mhvwerts/SFRMATRIX-LED-light/LED_holder_SM30tube/bague_portediode.pdf

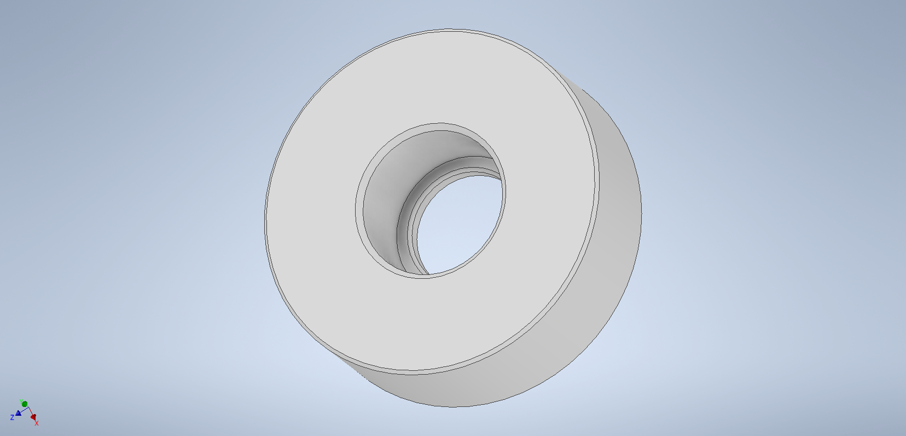
[picture p6: page 1]
