mhvwerts/SFRMATRIX-LED-light/LED_holder_SM30tube/sup_diode4mm.pdf

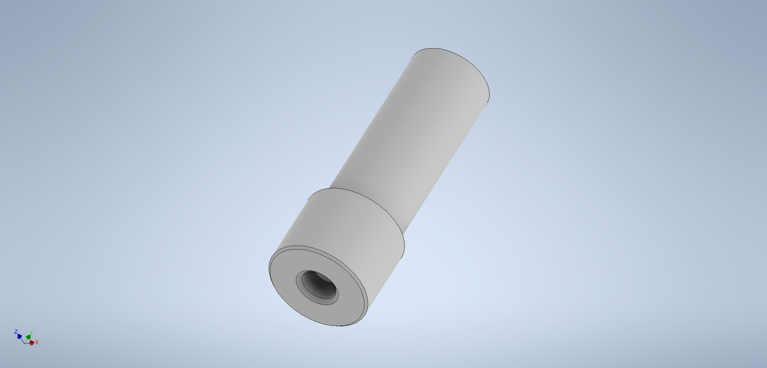
[picture p7: page 1]
