mhvwerts/SFRMATRIX-LED-light/LED_holder_SM30tube/sup_diode3mm.stl

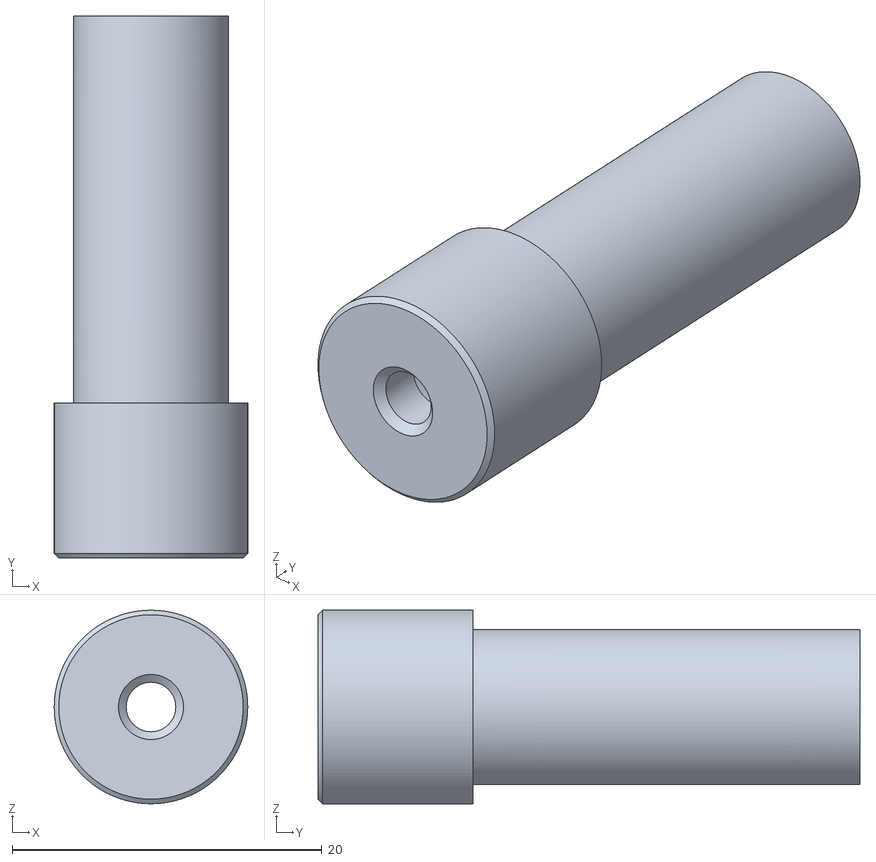
[picture p8: CAD file, 2026-10-27]
LED_holder_SM30tube/sup_diode3mm.stl
12.5 x 35.0 x 12.5
