mhvwerts/SFRMATRIX-LED-light/LED_holder_SM30tube/bague_portediode.stl

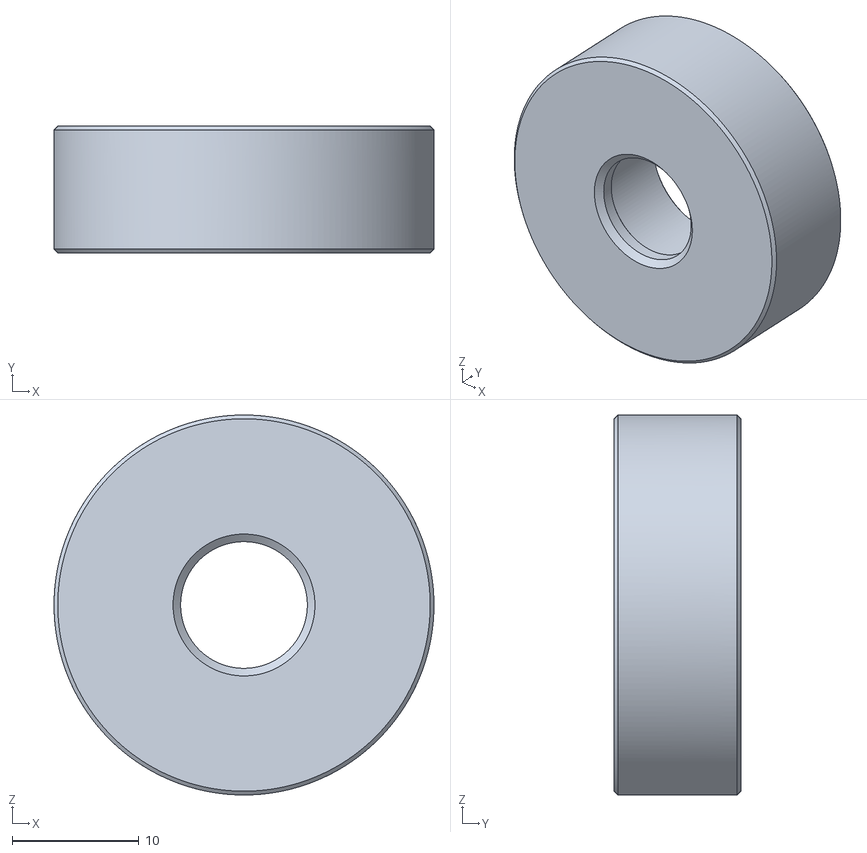
[picture p9: CAD file, 2026-10-27]
LED_holder_SM30tube/bague_portediode.stl
30.0 x 10.0 x 30.0
