mhvwerts/SFRMATRIX-LED-light/(list of files, cad)

Other CAD files:
LED_holder_SM30tube/sup_diode4mm.stl
LED_holder_SM30tube/sup_diode5mm.stl
LED_holder_SM30tube/bague_portediodesimple.ipt
LED_holder_SM30tube/sup_diode3mm.ipt
LED_holder_SM30tube/sup_diode4mm.ipt
LED_holder_SM30tube/sup_diode5mm.ipt
